alkaliu/LH_Dimmer/README.md

# LH_Dimmer
Led strip dimmer based on Arduino(ProMicro), PCA9685, and mosfets
