alkaliu/LH_Dimmer/LHDimmer-src/Readme

1.
Undefine USB LEDs to use them freeley in platform file: core/variant/pins_arduino.h

#define TXLED0
#define TXLED1
#define RXLED0
#define RXLED1
#define TX_RX_LED_INIT

//#define TXLED0			PORTD &= ~(1<<5)
//#define TXLED1			PORTD |= (1<<5)
//#define RXLED0			PORTB &= ~(1<<0)
//#define RXLED1			PORTB |= (1<<0)
//#define TX_RX_LED_INIT	DDRD |= (1<<5), DDRB |= (1<<0), TXLED0, RXLED0
