alkaliu/LH_Dimmer/data/lh_dimmer_1.0_panel.pdf

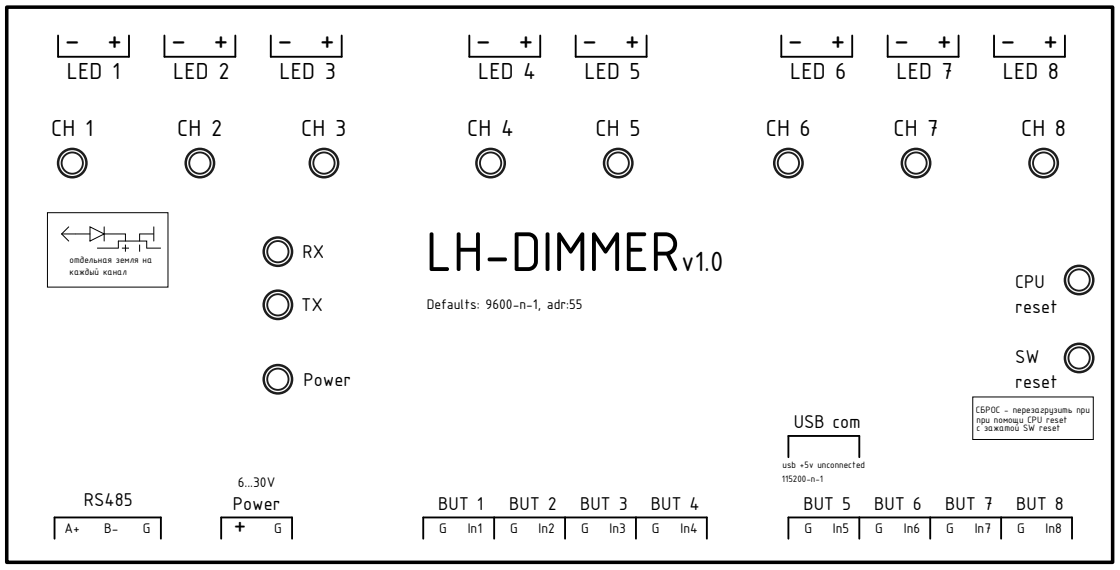
[picture p1: figure]
LED 1; Power; BUT 1; BUT 2; BUT 3; BUT 4; BUT 5; BUT 6; BUT 7; BUT 8; LED 2; LED 4; LED 5; LED 3; LED 6; LED 7; LED 8; USB com; usb +5v unconnected; отдельная земля на; каждый канал; CPU; reset; LH-DIMMERv1.0; Defaults: 9600-n-1, adr:55

СБРОС - перезагрузить при при помощи CPU reset с зажатой SW reset
