alkaliu/LH_Dimmer/kicad/lh-dimmer_1.0/1.0/box/1.0-Edge_Cuts.dxf

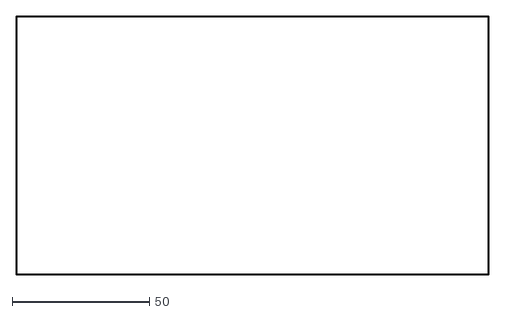
[picture p2: CAD file, 2022-10-06]
kicad/lh-dimmer_1.0/1.0/box/1.0-Edge_Cuts.dxf
172.3 x 94.3
