alkaliu/LH_Dimmer/(list of files, cad)

Other CAD files:
kicad/lh-dimmer_1.0/1.0/box/1.0-F_Silkscreen.dxf
