alkaliu/LH_Dimmer/kicad/lh-dimmer_1.0/1.0/LH_dimmer_v1.0.pdf

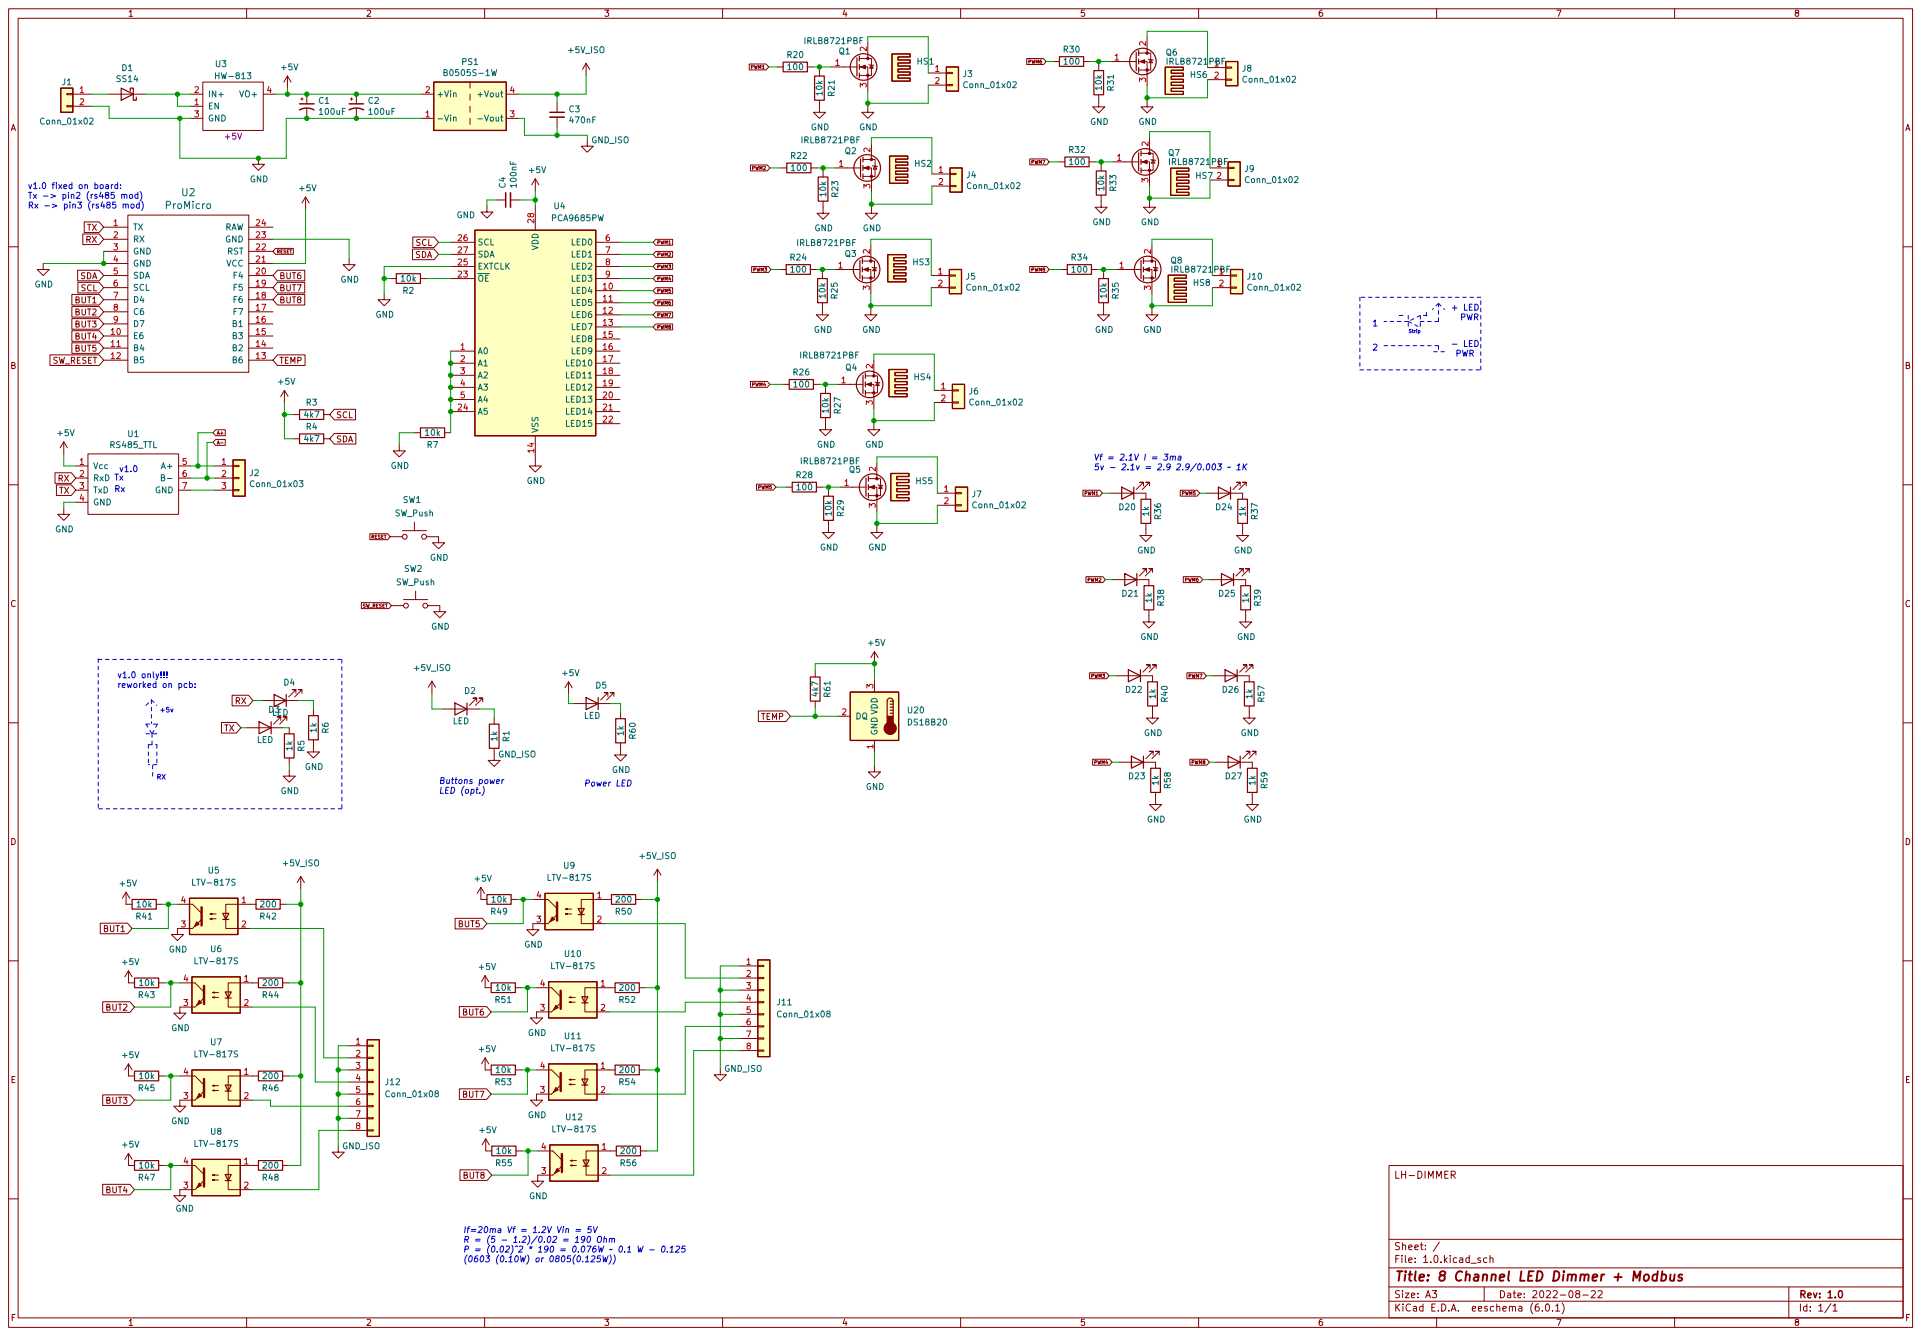
[picture p3: page 1]

v1.0 fixed on board: Tx -> pin2 (rs485 mod)

File: 1.0.kicad_sch Sheet: / LH-DIMMER

If=20ma Vf = 1.2V Vin = 5V R = (5 - 1.2)/0.02 = 190 Ohm

Id: 1/1 Title: 8 Channel LED Dimmer + Modbus
