alkaliu/LH_Dimmer/kicad/lh-dimmer_1.0/1.0/1.0.kicad_pcb

## KiCad design kicad/lh-dimmer_1.0/1.0/1.0.kicad_pcb (2022-10-06)

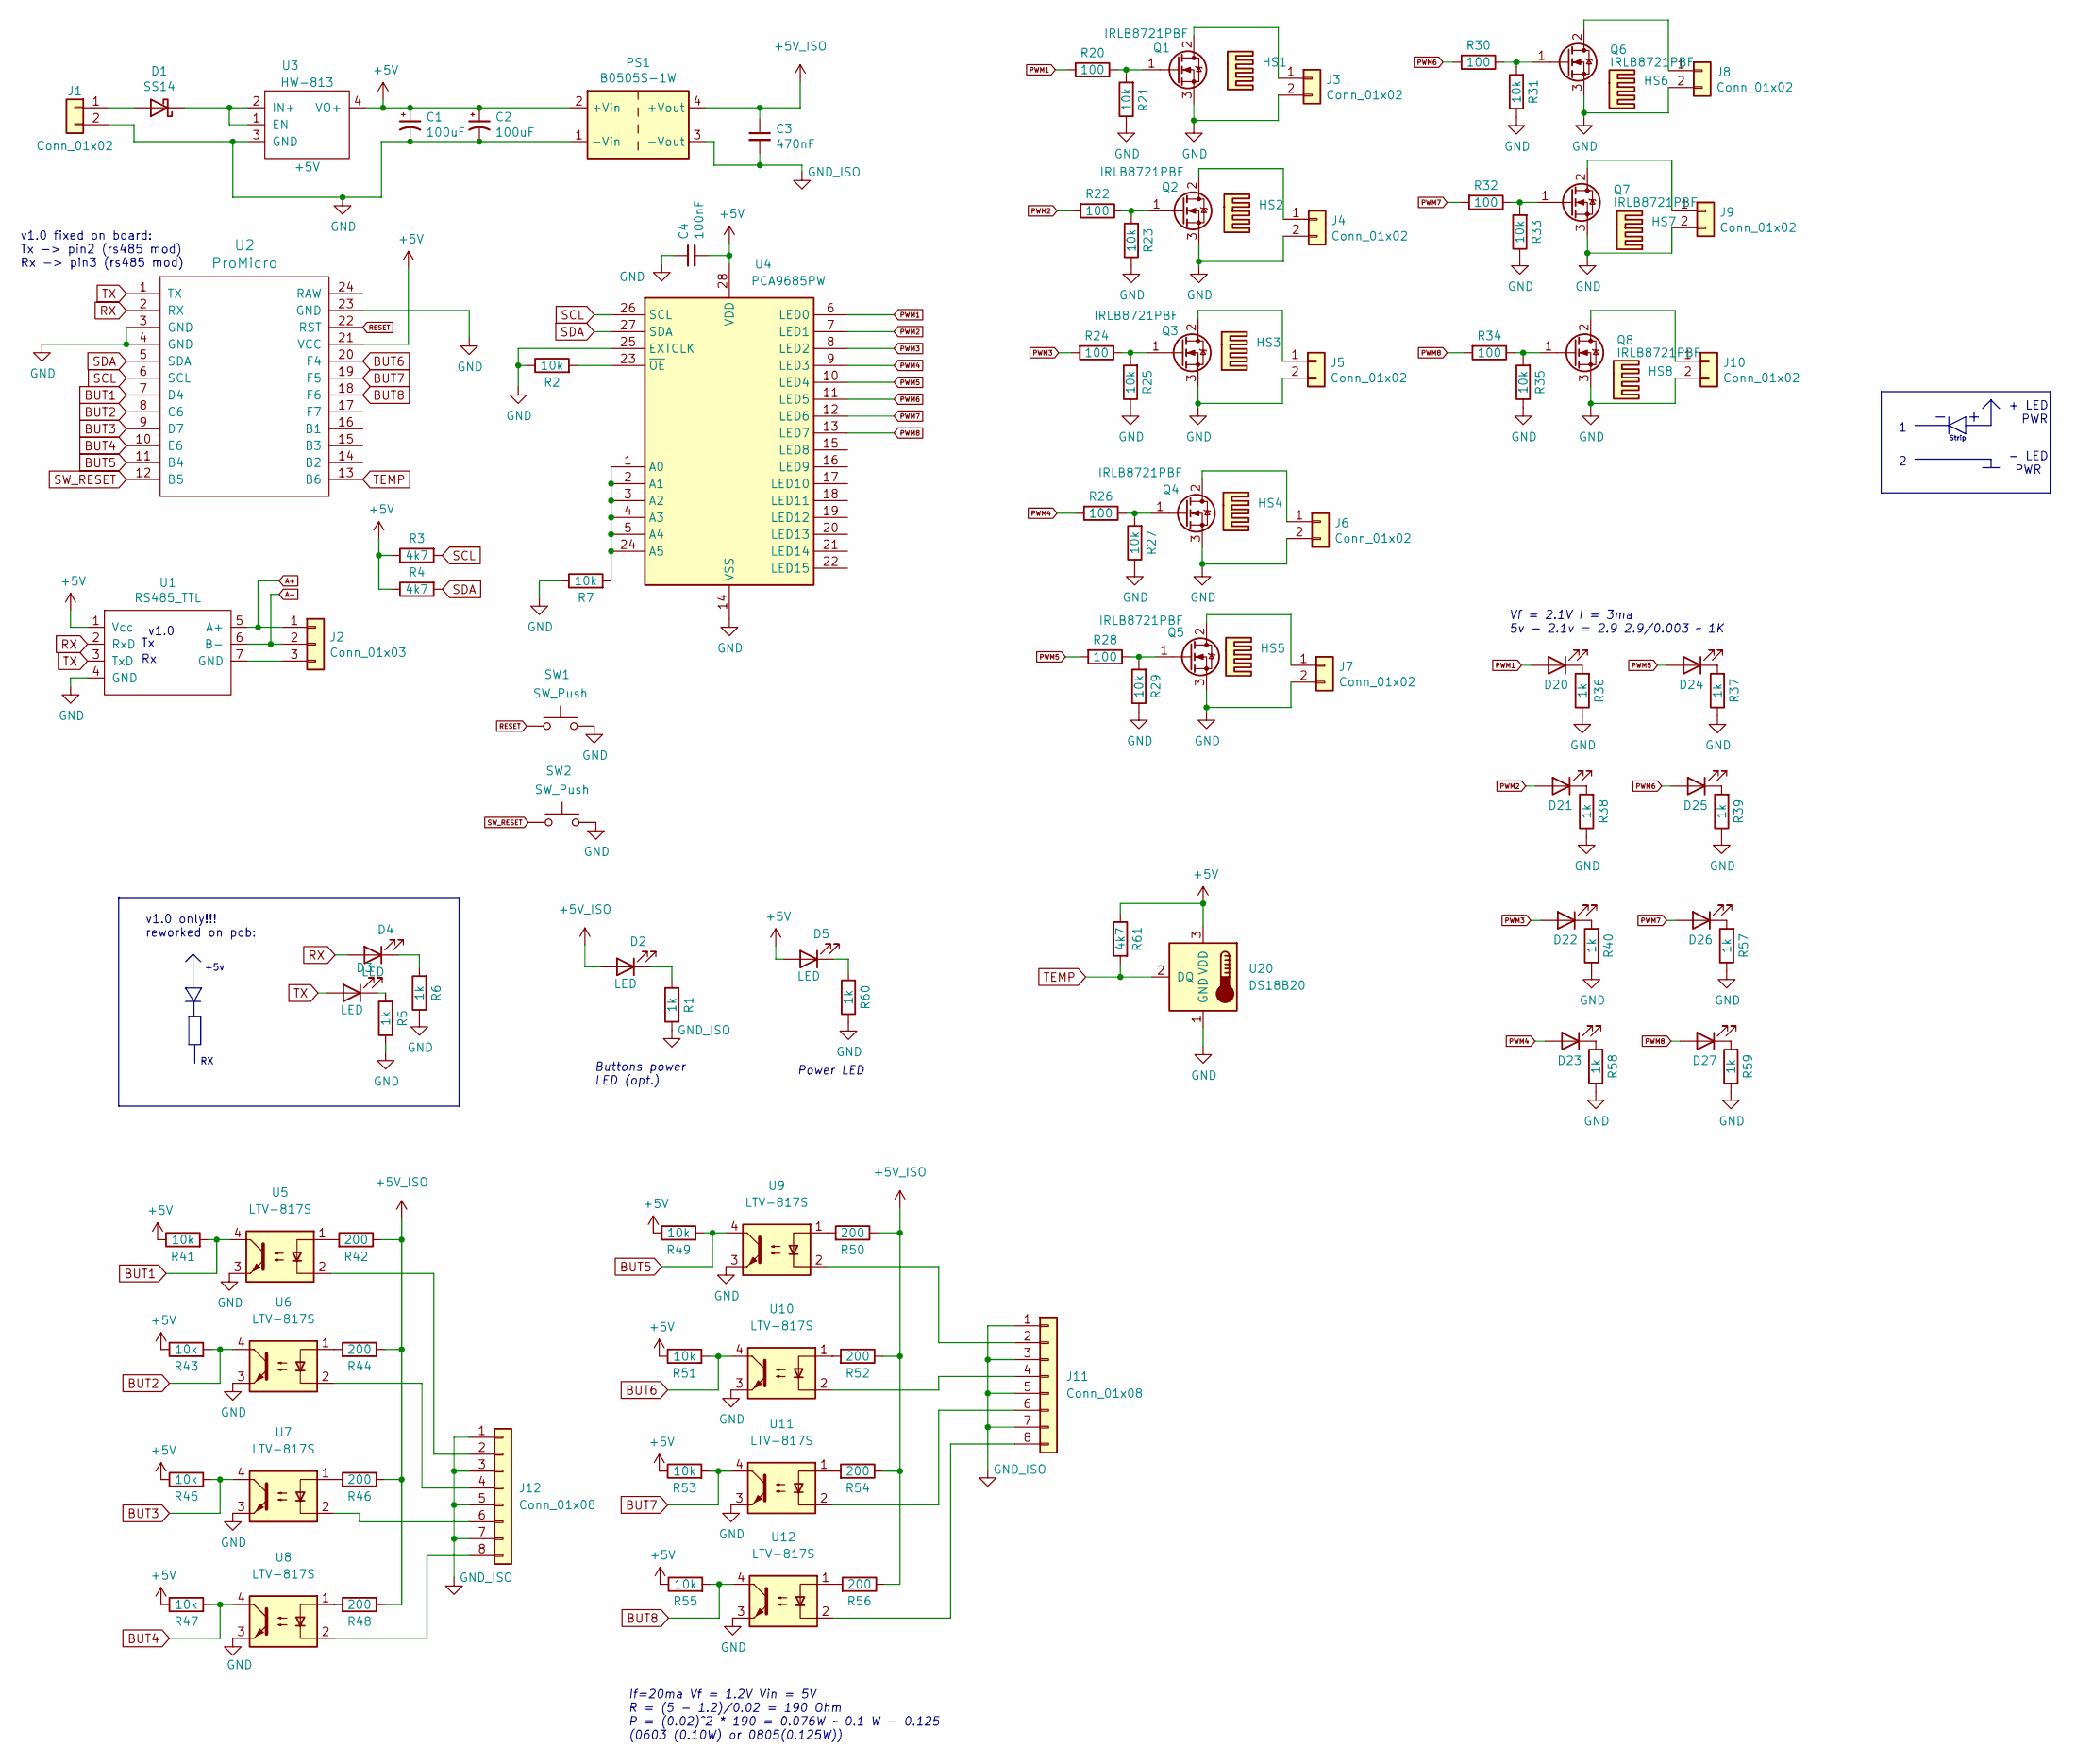
[picture p4: schematic 1.0.kicad_sch, 8 Channel LED Dimmer + Modbus]

Parts:
C1, C2: 100uF; CP_Radial_D8.0mm_P3.50mm
C3: 470nF; C_1206_3216Metric_Pad1.33x1.80mm_HandSolder
C4: 100nF; C_1206_3216Metric_Pad1.33x1.80mm_HandSolder
D1: SS14; D_SMA
D2, D3, D4, D5, D20, D21, D22, D23, D24, D25, D26, D27: LED; LED_D3.0mm
HS1, HS2, HS3, HS4, HS5, HS6, HS7, HS8: Heatsink; DY-CN-025
J1, J3, J4, J5, J6, J7, J8, J9, J10: Conn_01x02; PhoenixContact_MSTBA_2,5_2-G-5,08_1x02_P5.08mm_Horizontal
J2: Conn_01x03; PhoenixContact_MSTBA_2,5_3-G-5,08_1x03_P5.08mm_Horizontal
J11, J12: Conn_01x08; PhoenixContact_MSTBA_2,5_8-G-5,08_1x08_P5.08mm_Horizontal
PS1: B0505S-1W; Converter_DCDC_Murata_MEE1SxxxxSC_THT
Q1, Q2, Q3, Q4, Q5, Q6, Q7, Q8: IRLB8721PBF; TO-220-3_Vertical
R1, R5, R6, R36, R37, R38, R39, R40, R57, R58, R59, R60: 1k; R_0805_2012Metric_Pad1.20x1.40mm_HandSolder
R2, R7, R21, R23, R25, R27, R29, R31, R33, R35, R41, R43, R45, R47, R49, R51, R53, R55: 10k; R_0805_2012Metric_Pad1.20x1.40mm_HandSolder
R3, R4, R61: 4k7; R_0805_2012Metric_Pad1.20x1.40mm_HandSolder
R20, R22, R24, R26, R28, R30, R32, R34: 100; R_0805_2012Metric_Pad1.20x1.40mm_HandSolder
R42, R44, R46, R48, R50, R52, R54, R56: 200; R_0805_2012Metric_Pad1.20x1.40mm_HandSolder
SW1, SW2: SW_Push; SW_PUSH_6mm_H4.3mm
U1: RS485_TTL; RS485_TTL_1
U2: ProMicro; ProMicroDsh
U3: HW-813; HM813_V_A
U4: PCA9685PW; TSSOP-28_4.4x9.7mm_P0.65mm
U5, U6, U7, U8, U9, U10, U11, U12: LTV-817S; SMDIP-4_W9.53mm
U20: DS18B20; TO-92_Inline

Connections:
+5V: C1.1, C2.1, C4.2, D5.2 (A), PS1.2 (+Vin), R3.1, R4.1, R41.1, R43.1, R45.1, R47.1, R49.1, R51.1, R53.1, R55.1, R61.1, U1.1 (Vcc), U2.21 (VCC), U3.4 (VO+), U4.28 (VDD), U20.3 (VDD)
+5V_ISO: C3.1, D2.2 (A), PS1.4 (+Vout), R42.1, R44.1, R46.1, R48.1, R50.1, R52.1, R54.1, R56.1
A+: J2.1, U1.5 (A+)
A-: J2.2, U1.6 (B-)
BUT1: R41.2, U2.7 (D4), U5.4
BUT2: R43.2, U2.8 (C6), U6.4
BUT3: R45.2, U2.9 (D7), U7.4
BUT4: R47.2, U2.10 (E6), U8.4
BUT5: R49.2, U2.11 (B4), U9.4
BUT6: R51.2, U2.20 (F4), U10.4
BUT7: R53.2, U2.19 (F5), U11.4
BUT8: R55.2, U2.18 (F6), U12.4
GND: C1.2, C2.2, C4.1, J1.2, J3.2, J4.2, J5.2, J6.2, J7.2, J8.2, J9.2, J10.2, PS1.1 (-Vin), Q1.3 (S), Q2.3 (S), Q3.3 (S), Q4.3 (S), Q5.3 (S), Q6.3 (S), Q7.3 (S), Q8.3 (S), R2.1, R5.1, R6.1, R7.1, R21.1, R23.1, R25.1, R27.1, R29.1, R31.1, R33.1, R35.1, R36.1, R37.1, R38.1, R39.1, R40.1, R57.1, R58.1, R59.1, R60.1, SW1.2, SW2.2, U1.4 (GND), U2.3 (GND), U2.4 (GND), U2.23 (GND), U3.3 (GND), U4.14 (VSS), U4.25 (EXTCLK), U5.3, U6.3, U7.3, U8.3, U9.3, U10.3, U11.3, U12.3, U20.1 (GND)
GND_ISO: C3.2, J11.1, J11.3, J11.5, J11.7, J12.1, J12.3, J12.5, J12.7, PS1.3 (-Vout), R1.1
unnamed: D1.1 (K), U3.1 (EN), U3.2 (IN+)
unnamed: D1.2 (A), J1.1
unnamed: D2.1 (K), R1.2
unnamed: D3.1 (K), R5.2
unnamed: D4.1 (K), R6.2
unnamed: D5.1 (K), R60.2
unnamed: J2.3, U1.7 (GND)
unnamed: J3.1, Q1.2 (D)
unnamed: J4.1, Q2.2 (D)
unnamed: J5.1, Q3.2 (D)
unnamed: J6.1, Q4.2 (D)
unnamed: J7.1, Q5.2 (D)
unnamed: J8.1, Q6.2 (D)
unnamed: J9.1, Q7.2 (D)
unnamed: J10.1, Q8.2 (D)
unnamed: J11.2, U9.2
unnamed: J11.4, U10.2
unnamed: J11.6, U11.2
unnamed: J11.8, U12.2
unnamed: J12.2, U5.2
unnamed: J12.4, U6.2
unnamed: J12.6, U7.2
unnamed: J12.8, U8.2
unnamed: Q1.1 (G), R20.1, R21.2
unnamed: Q2.1 (G), R22.1, R23.2
unnamed: Q3.1 (G), R24.1, R25.2
unnamed: Q4.1 (G), R26.1, R27.2
unnamed: Q5.1 (G), R28.1, R29.2
unnamed: Q6.1 (G), R30.1, R31.2
unnamed: Q7.1 (G), R32.1, R33.2
unnamed: Q8.1 (G), R34.1, R35.2
unnamed: R2.2, U4.23 (~OE)
unnamed: R7.2, U4.1 (A0), U4.2 (A1), U4.3 (A2), U4.4 (A3), U4.5 (A4), U4.24 (A5)
unnamed: D20.1 (K), R36.2
unnamed: D24.1 (K), R37.2
unnamed: D21.1 (K), R38.2
unnamed: D25.1 (K), R39.2
unnamed: D22.1 (K), R40.2
unnamed: R42.2, U5.1
unnamed: R44.2, U6.1
unnamed: R46.2, U7.1
unnamed: R48.2, U8.1
unnamed: R50.2, U9.1
unnamed: R52.2, U10.1
unnamed: R54.2, U11.1
unnamed: R56.2, U12.1
unnamed: D26.1 (K), R57.2
unnamed: D23.1 (K), R58.2
unnamed: D27.1 (K), R59.2
PWM1: D20.2 (A), R20.2, U4.6 (LED0)
PWM2: D21.2 (A), R22.2, U4.7 (LED1)
PWM3: D22.2 (A), R24.2, U4.8 (LED2)
PWM4: D23.2 (A), R26.2, U4.9 (LED3)
PWM5: D24.2 (A), R28.2, U4.10 (LED4)
PWM6: D25.2 (A), R30.2, U4.11 (LED5)
PWM7: D26.2 (A), R32.2, U4.12 (LED6)
PWM8: D27.2 (A), R34.2, U4.13 (LED7)
RESET: SW1.1, U2.22 (RST)
RX: D4.2 (A), U1.2 (RxD), U2.2 (RX)
SCL: R3.2, U2.6 (SCL), U4.26 (SCL)
SDA: R4.2, U2.5 (SDA), U4.27 (SDA)
SW_RESET: SW2.1, U2.12 (B5)
TEMP: R61.2, U2.13 (B6), U20.2 (DQ)
TX: D3.2 (A), U1.3 (TxD), U2.1 (TX)

Notes on the sheet:
Buttons power LED (opt.)
v1.0
Strip
- LED PWR
v1.0 fixed on board: Tx -> pin2 (rs485 mod) Rx -> pin3 (rs485 mod)
Power LED
+5v
v1.0 only!!! reworked on pcb:
Vf = 2.1V I = 3ma 5v - 2.1v = 2.9 2.9/0.003 ~ 1K
If=20ma Vf = 1.2V Vin = 5V R = (5 - 1.2)/0.02 = 190 Ohm P = (0.02)^2 * 190 = 0.076W ~ 0.1 W - 0.125 (0603 (0.10W) or 0805(0.125W))
+ LED PWR

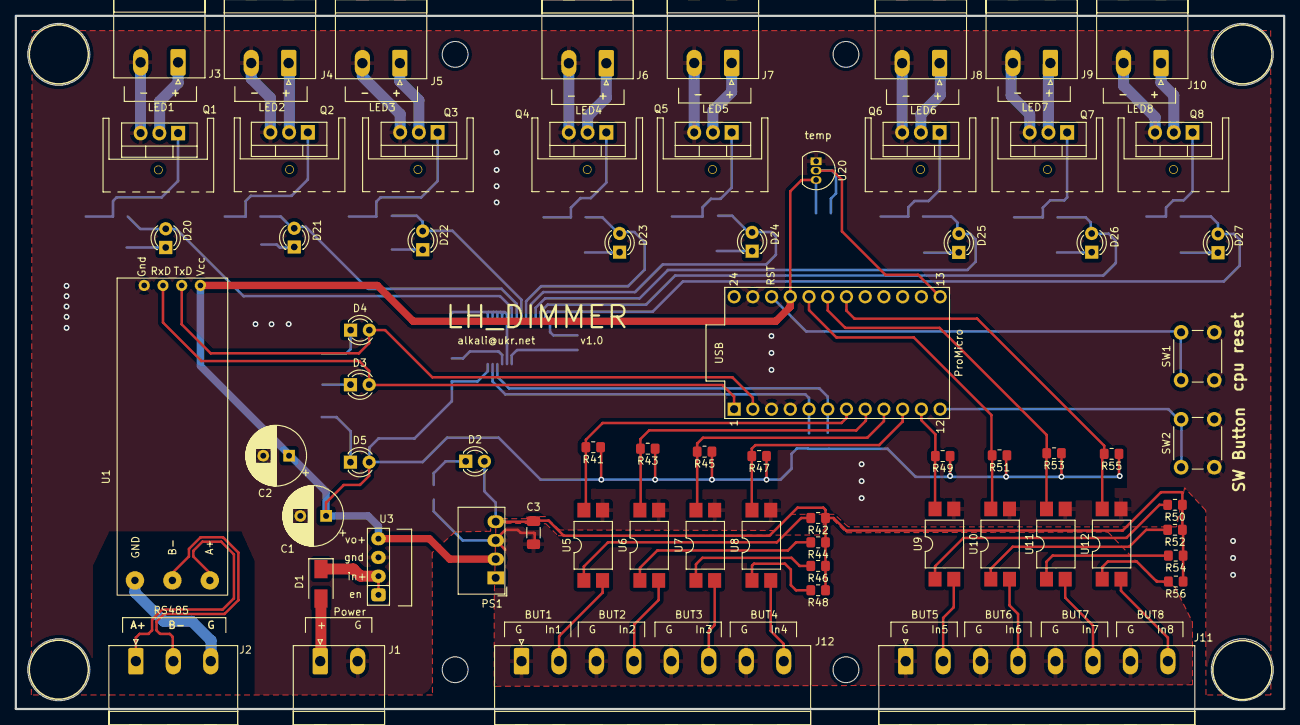
[picture p5: board 1.0.kicad_pcb from above]

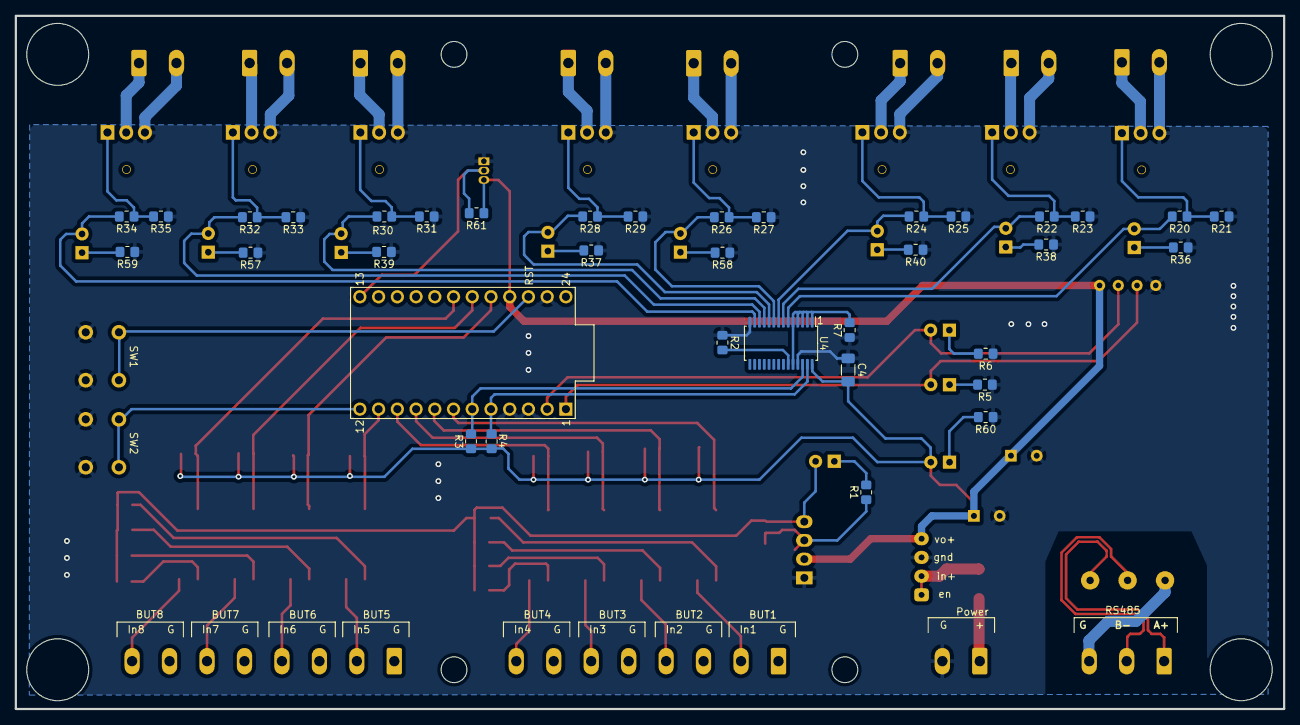
[picture p6: board 1.0.kicad_pcb from below]

Board: 2 copper layers, 172.0 x 94.0 mm, 110 parts (35 on the bottom side), 78 nets.
