alkaliu/LH_Dimmer/(commit log)

2022-10-06 Load version 1.0 code+sch+pcb
    [1.0-Edge_Cuts.dxf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]
2022-10-06 Add modbus registers map
    [Modbus_LH-dimmer.xlsx]
